monogon-dev/usbarmory-mk2-touchscreen/(commit log)

2023-04-04 Initial import
    [usbarmory-breakout.kicad_pcb, usbarmory-breakout.kicad_sch]
2023-04-04 Swapped MOSI and MISO, renamed nets.
    [usbarmory-breakout.kicad_pcb, usbarmory-breakout.kicad_sch]
2023-04-04 Added the production files.
    [usbarmory-breakout-B_Cu.gbr, usbarmory-breakout-B_Mask.gbr, usbarmory-breakout-B_Silkscreen.gbr, usbarmory-breakout-Edge_Cuts.gbr, usbarmory-breakout-F_Cu.gbr, usbarmory-breakout-F_Mask.gbr, usbarmory-breakout-F_Silkscreen.gbr, usbarmory-breakout-NPTH.drl]
2023-04-04 Updated BOM.
